DucDuyCPD/ascon_accerlerator/document/ascon_block_diagram.pdf

# thiết kế khối Ascon-Encrypt_Decrypt

## Mux

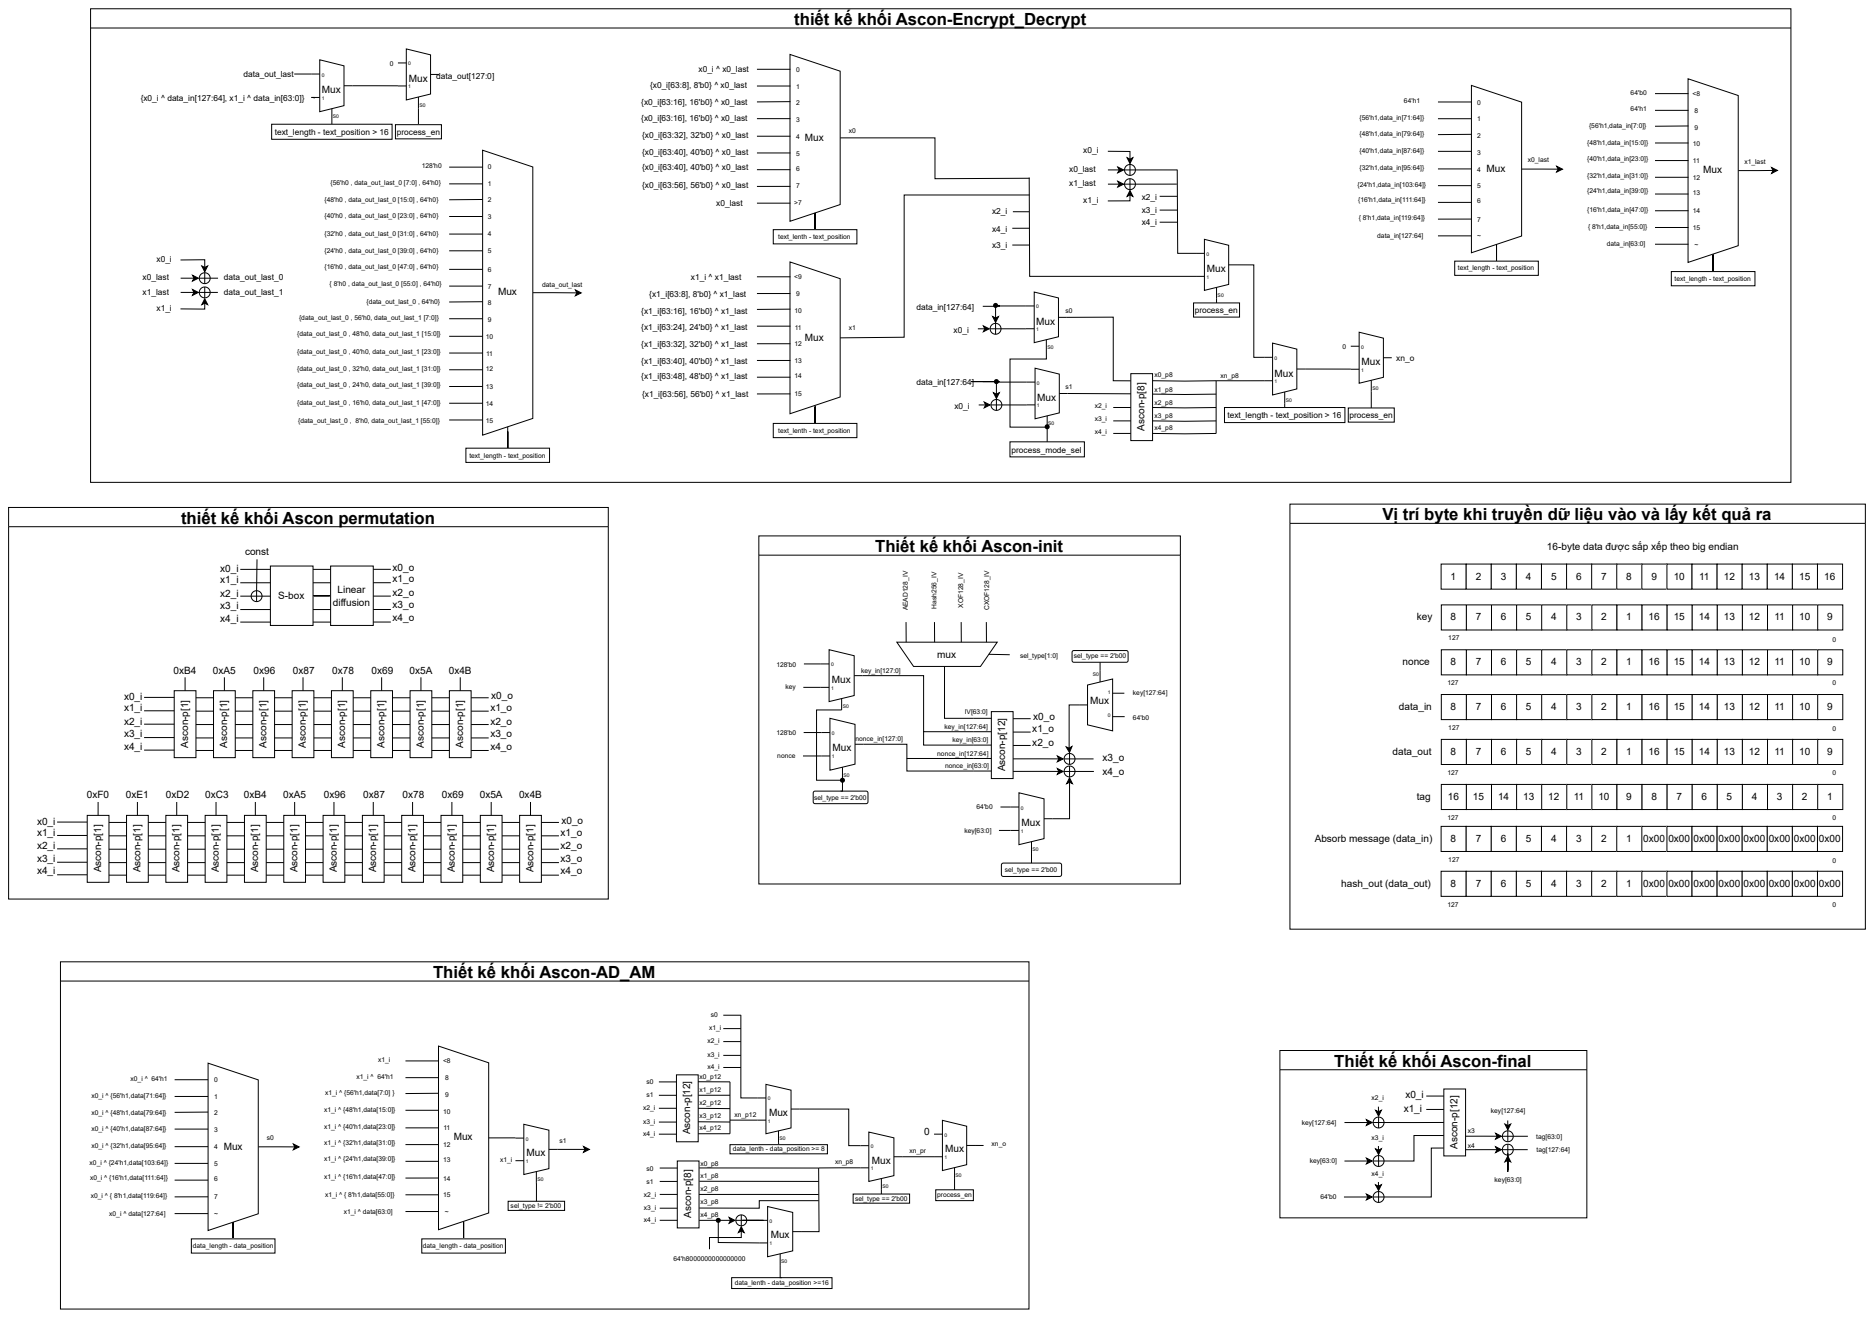
[picture p32: page 1]
text_length - text_position; {56'h1,data_in[71:64]}; {48'h1,data_in[79:64]}; {40'h1,data_in[87:64]}; {32'h1,data_in[95:64]}; {24'h1,data_in[103:64]}; {16'h1,data_in[111:64]}; { 8'h1,data_in[119:64]}; data_in[127:64]; x0_last; Mux; {56'h1,data_in[7:0]}; {48'h1,data_in[15:0]}; {40'h1,data_in[23:0]}; {32'h1,data_in[31:0]}; {24'h1,data_in[39:0]}; {16'h1,data_in[47:0]}; { 8'h1,data_in[55:0]}; data_in[63:0]; x1_last; process_en; data_out[127:0]; text_length - text_position > 16; process_mode_sel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

thiết kế khối Ascon permutation

Vị trí byte khi truyền dữ liệu vào và lấy kết quả ra

Thiết kế khối Ascon-init

16-byte data được sắp xếp theo big endian

Thiết kế khối Ascon-AD_AM

Thiết kế khối Ascon-final Ascon⁻p[12]

# Thiết kế khối Ascon Core (top module)

## mode_sel_encrypt_decrypt

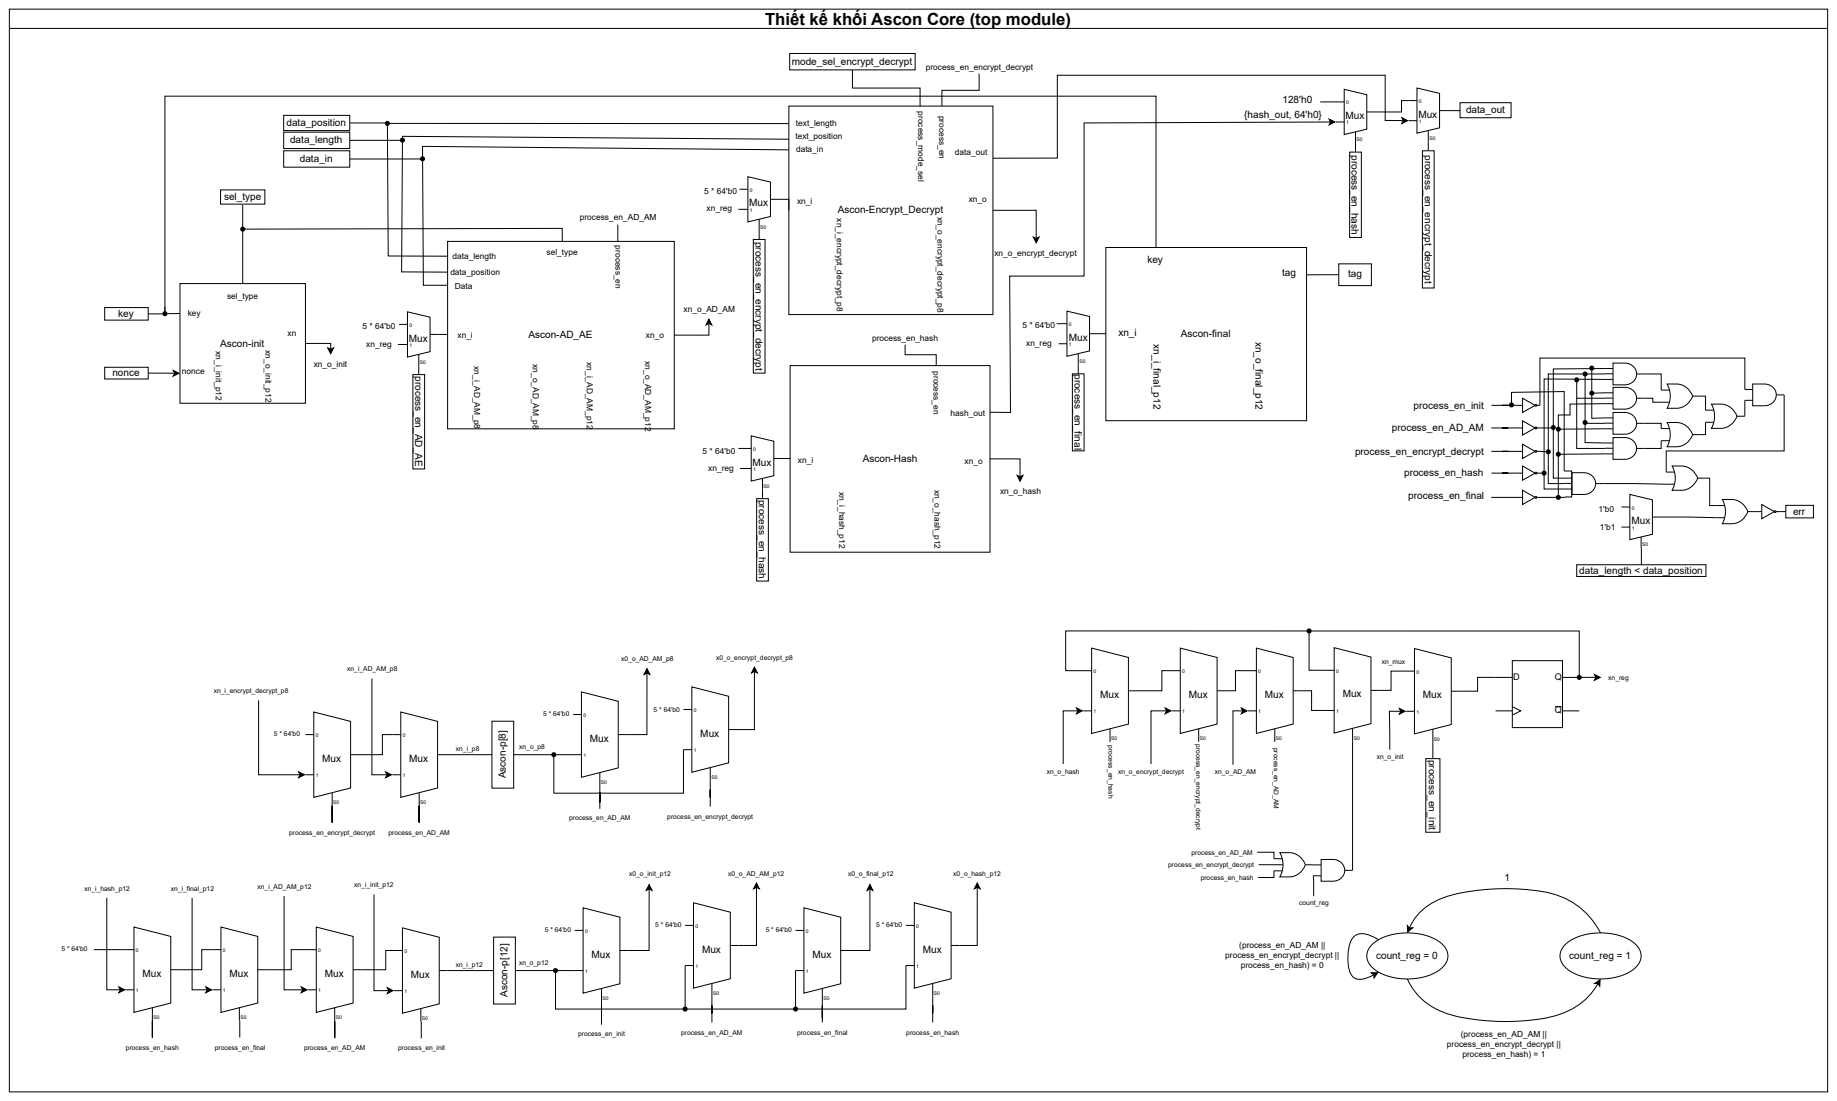
[picture p33: page 2]
Ascon-init; Ascon-AD_AE; Ascon-Encrypt_Decrypt; Ascon-Hash; Ascon-final; xn_i_init_p12; xn_o_init_p12; sel_type; key; nonce; xn_o process_en; sel_type data_length; data_position Data; xn_i_encrypt_decrypt_p8; xn_o_encrypt_decrypt_p8; data_out data_in; text_length text_position; process_mode_sel; process_en; hash_out; xn_o xn_i_hash_p12; xn_o_hash_p12; tag; xn_i_final_p12; xn_o_final_p12; Ascon-p[8]; Mux; process_en_encrypt_decrypt; process_en_AD_AM; x0_o_encrypt_decrypt_p8; Ascon-p[12]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
