DucDuyCPD/ascon_accerlerator/ascon_core_verilog/rtl/ascon_core.v

`timescale  1ns/1ps
module ascon_core (
	input wire clk,
	input wire rst_n,
	
	input wire [127:0] key,
	input wire [127:0] nonce,

	input wire [1:0] sel_type,
	input wire mode_sel_encrypt_decrypt,

	input wire [31:0] data_length,
	input wire [31:0] data_position,

	input wire [127:0] data_in,
	output reg [127:0] data_out,

	input wire process_en_init,
	input wire process_en_AD_AM,
	input wire process_en_encrypt_decrypt,
	input wire process_en_hash,
	input wire process_en_final,

	output reg [127:0] tag,
	output reg done,

	output wire err
);

parameter AEAD128 = 2'b00;
parameter Hash256 = 2'b01;
parameter XOF128  = 2'b10;
parameter CXOF128 = 2'b11;

reg [63:0] x0, x1, x2, x3, x4;
reg count;

wire err_length, err_process_en;
assign err_length = (data_length < data_position) ? 1'b1 : 1'b0;
assign err_process_en = (process_en_init | process_en_AD_AM | process_en_encrypt_decrypt | process_en_hash) & (process_en_init | process_en_AD_AM | process_en_encrypt_decrypt | process_en_final) & (process_en_init | process_en_AD_AM | process_en_hash | process_en_final) & (process_en_init | process_en_encrypt_decrypt | process_en_hash | process_en_final) & (process_en_AD_AM | process_en_encrypt_decrypt | process_en_hash | process_en_final);
assign err = err_length | err_process_en;

wire [63:0] x0_init, x1_init, x2_init, x3_init, x4_init;
wire [63:0] x0_i_AD_AM, x1_i_AD_AM, x2_i_AD_AM, x3_i_AD_AM, x4_i_AD_AM, x0_o_AD_AM, x1_o_AD_AM, x2_o_AD_AM, x3_o_AD_AM, x4_o_AD_AM;
wire [63:0] x0_i_encrypt_decrypt, x1_i_encrypt_decrypt, x2_i_encrypt_decrypt, x3_i_encrypt_decrypt, x4_i_encrypt_decrypt, x0_o_encrypt_decrypt, x1_o_encrypt_decrypt, x2_o_encrypt_decrypt, x3_o_encrypt_decrypt, x4_o_encrypt_decrypt;
wire [63:0] x0_i_final, x1_i_final, x2_i_final, x3_i_final, x4_i_final;
wire [63:0] x0_i_hash, x1_i_hash, x2_i_hash, x3_i_hash, x4_i_hash, x0_o_hash, x1_o_hash, x2_o_hash, x3_o_hash, x4_o_hash;

wire [127:0] encrypt_decrypt_out;
wire [63:0] hash_out;

wire [63:0] x0_i_p12, x1_i_p12, x2_i_p12, x3_i_p12, x4_i_p12, x0_i_p8, x1_i_p8, x2_i_p8, x3_i_p8, x4_i_p8;
wire [63:0] x0_o_p12, x1_o_p12, x2_o_p12, x3_o_p12, x4_o_p12, x0_o_p8, x1_o_p8, x2_o_p8, x3_o_p8, x4_o_p8;

wire [63:0] x0_i_init_p12, x1_i_init_p12, x2_i_init_p12, x3_i_init_p12, x4_i_init_p12;
wire [63:0] x0_o_init_p12, x1_o_init_p12, x2_o_init_p12, x3_o_init_p12, x4_o_init_p12;

wire [63:0] x0_i_AD_AM_p8, x1_i_AD_AM_p8, x2_i_AD_AM_p8, x3_i_AD_AM_p8, x4_i_AD_AM_p8;
wire [63:0] x0_o_AD_AM_p8, x1_o_AD_AM_p8, x2_o_AD_AM_p8, x3_o_AD_AM_p8, x4_o_AD_AM_p8;
wire [63:0] x0_i_AD_AM_p12, x1_i_AD_AM_p12, x2_i_AD_AM_p12, x3_i_AD_AM_p12, x4_i_AD_AM_p12;
wire [63:0] x0_o_AD_AM_p12, x1_o_AD_AM_p12, x2_o_AD_AM_p12, x3_o_AD_AM_p12, x4_o_AD_AM_p12;

wire [63:0] x0_i_encrypt_decrypt_p8, x1_i_encrypt_decrypt_p8, x2_i_encrypt_decrypt_p8, x3_i_encrypt_decrypt_p8, x4_i_encrypt_decrypt_p8;
wire [63:0] x0_o_encrypt_decrypt_p8, x1_o_encrypt_decrypt_p8, x2_o_encrypt_decrypt_p8, x3_o_encrypt_decrypt_p8, x4_o_encrypt_decrypt_p8;

wire [63:0] x0_i_hash_p12, x1_i_hash_p12, x2_i_hash_p12, x3_i_hash_p12, x4_i_hash_p12;
wire [63:0] x0_o_hash_p12, x1_o_hash_p12, x2_o_hash_p12, x3_o_hash_p12, x4_o_hash_p12;

wire [63:0] x0_i_final_p12, x1_i_final_p12, x2_i_final_p12, x3_i_final_p12, x4_i_final_p12;
wire [63:0] x3_o_final_p12, x4_o_final_p12;

wire [127:0] data_out_temp;
wire [127:0] tag_temp;

wire [63:0] x0_i_p, x1_i_p, x2_i_p, x3_i_p, x4_i_p;
wire [63:0] x0_o_p, x1_o_p, x2_o_p, x3_o_p, x4_o_p;
wire done_p, en_p8, en_p12;

assign data_out_temp = 	(process_en_encrypt_decrypt) ? encrypt_decrypt_out :
						(process_en_hash) ? {hash_out,64'b0} : data_out;

wire [63:0] x0_mux, x1_mux, x2_mux, x3_mux, x4_mux;

wire [63:0] x0_mux_temp, x1_mux_temp, x2_mux_temp, x3_mux_temp, x4_mux_temp;

assign x0_mux_temp = (process_en_AD_AM) ? x0_o_AD_AM : 
					(process_en_encrypt_decrypt) ? x0_o_encrypt_decrypt : 
					(process_en_hash) ? x0_o_hash : x0;
assign x0_mux = 	((process_en_AD_AM | process_en_encrypt_decrypt | process_en_hash) & count) ? x0_mux_temp : x0;
 
assign x1_mux_temp = (process_en_AD_AM) ? x1_o_AD_AM : 
					(process_en_encrypt_decrypt) ? x1_o_encrypt_decrypt : 
					(process_en_hash) ? x1_o_hash : x1;
assign x1_mux = 	((process_en_AD_AM | process_en_encrypt_decrypt | process_en_hash) & count) ? x1_mux_temp : x1;

assign x2_mux_temp = (process_en_AD_AM) ? x2_o_AD_AM : 
					(process_en_encrypt_decrypt) ? x2_o_encrypt_decrypt : 
					(process_en_hash) ? x2_o_hash : x2;
assign x2_mux = 	((process_en_AD_AM | process_en_encrypt_decrypt | process_en_hash) & count) ? x2_mux_temp : x2;

assign x3_mux_temp = (process_en_AD_AM) ? x3_o_AD_AM : 
					(process_en_encrypt_decrypt) ? x3_o_encrypt_decrypt : 
					(process_en_hash) ? x3_o_hash : x3;
assign x3_mux = 	((process_en_AD_AM | process_en_encrypt_decrypt | process_en_hash) & count) ? x3_mux_temp : x3;

assign x4_mux_temp = (process_en_AD_AM) ? x4_o_AD_AM : 
					(process_en_encrypt_decrypt) ? x4_o_encrypt_decrypt : 
					(process_en_hash) ? x4_o_hash : x4;
assign x4_mux = 	((process_en_AD_AM | process_en_encrypt_decrypt | process_en_hash) & count) ? x4_mux_temp : x4;

always @(posedge clk or negedge rst_n) begin
	if(~rst_n) begin
		x0 <= 64'b0;
		x1 <= 64'b0;
		x2 <= 64'b0;
		x3 <= 64'b0;
		x4 <= 64'b0;
		count <= 0;
		data_out <= 128'b0;
		done <=  0;
		tag <= 128'h0;
	end else begin
		if (err) begin
			x0 <= 64'b0;
			x1 <= 64'b0;
			x2 <= 64'b0;
			x3 <= 64'b0;
			x4 <= 64'b0;
			count <= 0;
			data_out <= 128'b0;
			done <=  0;
			tag <= 128'h0;
		end else begin
			data_out <= data_out_temp;
			if (process_en_init & done_p) begin
				x0 <= x0_init;
				x1 <= x1_init;
				x2 <= x2_init;
				x3 <= x3_init;
				x4 <= x4_init;
				done <= 1'b1;
			end else begin
				done <=  count;
				if (count == 1'b0) begin
					if ((process_en_AD_AM | process_en_encrypt_decrypt | process_en_hash | process_en_final) & done_p) count <= 1'b1; 
					else count <= 1'b0;
				end else begin
					x0 <= x0_mux;
					x1 <= x1_mux;
					x2 <= x2_mux;
					x3 <= x3_mux;
					x4 <= x4_mux;
					tag <= tag_temp;
					count <= 1'b0;
				end
			end
		end
	end
end

assign x0_i_p8 = 	(process_en_AD_AM) ? x0_i_AD_AM_p8 : 
					(process_en_encrypt_decrypt) ? x0_i_encrypt_decrypt_p8 : 64'b0;
assign x1_i_p8 = 	(process_en_AD_AM) ? x1_i_AD_AM_p8 : 
					(process_en_encrypt_decrypt) ? x1_i_encrypt_decrypt_p8 : 64'b0;
assign x2_i_p8 = 	(process_en_AD_AM) ? x2_i_AD_AM_p8 : 
					(process_en_encrypt_decrypt) ? x2_i_encrypt_decrypt_p8 : 64'b0;
assign x3_i_p8 = 	(process_en_AD_AM) ? x3_i_AD_AM_p8 : 
					(process_en_encrypt_decrypt) ? x3_i_encrypt_decrypt_p8 : 64'b0;
assign x4_i_p8 = 	(process_en_AD_AM) ? x4_i_AD_AM_p8 : 
					(process_en_encrypt_decrypt) ? x4_i_encrypt_decrypt_p8 : 64'b0;

assign x0_i_p12 =	(process_en_init) ? x0_i_init_p12 :
					(process_en_AD_AM) ? x0_i_AD_AM_p12 :
					(process_en_final) ? x0_i_final_p12 :
					(process_en_hash) ? x0_i_hash_p12 : 64'b0;
assign x1_i_p12 =	(process_en_init) ? x1_i_init_p12 :
					(process_en_AD_AM) ? x1_i_AD_AM_p12 :
					(process_en_final) ? x1_i_final_p12 :
					(process_en_hash) ? x1_i_hash_p12 : 64'b0;
assign x2_i_p12 =	(process_en_init) ? x2_i_init_p12 :
					(process_en_AD_AM) ? x2_i_AD_AM_p12 :
					(process_en_final) ? x2_i_final_p12 :
					(process_en_hash) ? x2_i_hash_p12 : 64'b0; 
assign x3_i_p12 =	(process_en_init) ? x3_i_init_p12 :
					(process_en_AD_AM) ? x3_i_AD_AM_p12 :
					(process_en_final) ? x3_i_final_p12 :
					(process_en_hash) ? x3_i_hash_p12 : 64'b0;
assign x4_i_p12 =	(process_en_init) ? x4_i_init_p12 :
					(process_en_AD_AM) ? x4_i_AD_AM_p12 :
					(process_en_final) ? x4_i_final_p12 :
					(process_en_hash) ? x4_i_hash_p12 : 64'b0;

assign x0_o_init_p12 = (process_en_init) ? x0_o_p12 : 64'b0;
assign x1_o_init_p12 = (process_en_init) ? x1_o_p12 : 64'b0;
assign x2_o_init_p12 = (process_en_init) ? x2_o_p12 : 64'b0;
assign x3_o_init_p12 = (process_en_init) ? x3_o_p12 : 64'b0;
assign x4_o_init_p12 = (process_en_init) ? x4_o_p12 : 64'b0;

assign x0_o_AD_AM_p8 = (process_en_AD_AM) ? x0_o_p8 : 64'b0;
assign x1_o_AD_AM_p8 = (process_en_AD_AM) ? x1_o_p8 : 64'b0;
assign x2_o_AD_AM_p8 = (process_en_AD_AM) ? x2_o_p8 : 64'b0;
assign x3_o_AD_AM_p8 = (process_en_AD_AM) ? x3_o_p8 : 64'b0;
assign x4_o_AD_AM_p8 = (process_en_AD_AM) ? x4_o_p8 : 64'b0;

assign x0_o_AD_AM_p12 = (process_en_AD_AM) ? x0_o_p12 : 64'b0;
assign x1_o_AD_AM_p12 = (process_en_AD_AM) ? x1_o_p12 : 64'b0;
assign x2_o_AD_AM_p12 = (process_en_AD_AM) ? x2_o_p12 : 64'b0;
assign x3_o_AD_AM_p12 = (process_en_AD_AM) ? x3_o_p12 : 64'b0;
assign x4_o_AD_AM_p12 = (process_en_AD_AM) ? x4_o_p12 : 64'b0;

assign x0_o_encrypt_decrypt_p8 = (process_en_encrypt_decrypt) ? x0_o_p8 : 64'b0;
assign x1_o_encrypt_decrypt_p8 = (process_en_encrypt_decrypt) ? x1_o_p8 : 64'b0;
assign x2_o_encrypt_decrypt_p8 = (process_en_encrypt_decrypt) ? x2_o_p8 : 64'b0;
assign x3_o_encrypt_decrypt_p8 = (process_en_encrypt_decrypt) ? x3_o_p8 : 64'b0;
assign x4_o_encrypt_decrypt_p8 = (process_en_encrypt_decrypt) ? x4_o_p8 : 64'b0;

assign x0_o_hash_p12 = (process_en_hash) ? x0_o_p12 : 64'b0;
assign x1_o_hash_p12 = (process_en_hash) ? x1_o_p12 : 64'b0;
assign x2_o_hash_p12 = (process_en_hash) ? x2_o_p12 : 64'b0;
assign x3_o_hash_p12 = (process_en_hash) ? x3_o_p12 : 64'b0;
assign x4_o_hash_p12 = (process_en_hash) ? x4_o_p12 : 64'b0;

assign x3_o_final_p12 = (process_en_final) ? x3_o_p12 : 64'b0;
assign x4_o_final_p12 = (process_en_final) ? x4_o_p12 : 64'b0;

ascon_initialization ascon_initialization_module(
	.sel_type(sel_type),
	.key(key),
	.nonce(nonce),

	.x0(x0_init),
	.x1(x1_init),
	.x2(x2_init),
	.x3(x3_init),
	.x4(x4_init),

	.x0_i_init_p12(x0_i_init_p12),
	.x1_i_init_p12(x1_i_init_p12),
	.x2_i_init_p12(x2_i_init_p12),
	.x3_i_init_p12(x3_i_init_p12),
	.x4_i_init_p12(x4_i_init_p12),

	.x0_o_init_p12(x0_o_init_p12),
	.x1_o_init_p12(x1_o_init_p12),
	.x2_o_init_p12(x2_o_init_p12),
	.x3_o_init_p12(x3_o_init_p12),
	.x4_o_init_p12(x4_o_init_p12)
);

assign x0_i_AD_AM = (process_en_AD_AM) ? x0 : 64'b0;
assign x1_i_AD_AM = (process_en_AD_AM) ? x1 : 64'b0;
assign x2_i_AD_AM = (process_en_AD_AM) ? x2 : 64'b0;
assign x3_i_AD_AM = (process_en_AD_AM) ? x3 : 64'b0;
assign x4_i_AD_AM = (process_en_AD_AM) ? x4 : 64'b0;

ascon_AD_AM ascon_AD_AM_module(
	.clk(clk), .rst_n(rst_n),

	.process_en(process_en_AD_AM),
	.sel_type(sel_type),

	.data_length(data_length),
	.data_position(data_position),

	.data(data_in),

	.x0_i(x0_i_AD_AM),
	.x1_i(x1_i_AD_AM),
	.x2_i(x2_i_AD_AM),
	.x3_i(x3_i_AD_AM),
	.x4_i(x4_i_AD_AM),

	.x0_o(x0_o_AD_AM),
	.x1_o(x1_o_AD_AM),
	.x2_o(x2_o_AD_AM),
	.x3_o(x3_o_AD_AM),
	.x4_o(x4_o_AD_AM),

	.x0_i_AD_AM_p8(x0_i_AD_AM_p8),
	.x1_i_AD_AM_p8(x1_i_AD_AM_p8),
	.x2_i_AD_AM_p8(x2_i_AD_AM_p8),
	.x3_i_AD_AM_p8(x3_i_AD_AM_p8),
	.x4_i_AD_AM_p8(x4_i_AD_AM_p8),

	.x0_o_AD_AM_p8(x0_o_AD_AM_p8),
	.x1_o_AD_AM_p8(x1_o_AD_AM_p8),
	.x2_o_AD_AM_p8(x2_o_AD_AM_p8),
	.x3_o_AD_AM_p8(x3_o_AD_AM_p8),
	.x4_o_AD_AM_p8(x4_o_AD_AM_p8),

	.x0_i_AD_AM_p12(x0_i_AD_AM_p12),
	.x1_i_AD_AM_p12(x1_i_AD_AM_p12),
	.x2_i_AD_AM_p12(x2_i_AD_AM_p12),
	.x3_i_AD_AM_p12(x3_i_AD_AM_p12),
	.x4_i_AD_AM_p12(x4_i_AD_AM_p12),

	.x0_o_AD_AM_p12(x0_o_AD_AM_p12),
	.x1_o_AD_AM_p12(x1_o_AD_AM_p12),
	.x2_o_AD_AM_p12(x2_o_AD_AM_p12),
	.x3_o_AD_AM_p12(x3_o_AD_AM_p12),
	.x4_o_AD_AM_p12(x4_o_AD_AM_p12)
);

assign x0_i_encrypt_decrypt = (process_en_encrypt_decrypt) ? x0 : 64'b0;
assign x1_i_encrypt_decrypt = (process_en_encrypt_decrypt) ? x1 : 64'b0;
assign x2_i_encrypt_decrypt = (process_en_encrypt_decrypt) ? x2 : 64'b0;
assign x3_i_encrypt_decrypt = (process_en_encrypt_decrypt) ? x3 : 64'b0;
assign x4_i_encrypt_decrypt = (process_en_encrypt_decrypt) ? x4 : 64'b0;

ascon_encrypt_decrypt ascon_encrypt_decrypt_module(
	.clk(clk), .rst_n(rst_n),

	.process_en(process_en_encrypt_decrypt),
	.process_mode_sel(mode_sel_encrypt_decrypt),

	.text_length(data_length),
	.text_position(data_position),

	.data_in(data_in),

	.x0_i(x0_i_encrypt_decrypt),
	.x1_i(x1_i_encrypt_decrypt),
	.x2_i(x2_i_encrypt_decrypt),
	.x3_i(x3_i_encrypt_decrypt),
	.x4_i(x4_i_encrypt_decrypt),

	.data_out(encrypt_decrypt_out),

	.x0_o(x0_o_encrypt_decrypt),
	.x1_o(x1_o_encrypt_decrypt),
	.x2_o(x2_o_encrypt_decrypt),
	.x3_o(x3_o_encrypt_decrypt),
	.x4_o(x4_o_encrypt_decrypt),

	.x0_i_encrypt_decrypt_p8(x0_i_encrypt_decrypt_p8),
	.x1_i_encrypt_decrypt_p8(x1_i_encrypt_decrypt_p8),
	.x2_i_encrypt_decrypt_p8(x2_i_encrypt_decrypt_p8),
	.x3_i_encrypt_decrypt_p8(x3_i_encrypt_decrypt_p8),
	.x4_i_encrypt_decrypt_p8(x4_i_encrypt_decrypt_p8),

	.x0_o_encrypt_decrypt_p8(x0_o_encrypt_decrypt_p8),
	.x1_o_encrypt_decrypt_p8(x1_o_encrypt_decrypt_p8),
	.x2_o_encrypt_decrypt_p8(x2_o_encrypt_decrypt_p8),
	.x3_o_encrypt_decrypt_p8(x3_o_encrypt_decrypt_p8),
	.x4_o_encrypt_decrypt_p8(x4_o_encrypt_decrypt_p8)
);

assign x0_i_final = (process_en_final) ? x0 : 64'b0;
assign x1_i_final = (process_en_final) ? x1 : 64'b0;
assign x2_i_final = (process_en_final) ? x2 : 64'b0;
assign x3_i_final = (process_en_final) ? x3 : 64'b0;
assign x4_i_final = (process_en_final) ? x4 : 64'b0;

ascon_finalization ascon_finalization_module(
	.clk(clk), .rst_n(rst_n),

	.process_en(process_en_final),

	.key(key),

	.x0_i(x0_i_final),
	.x1_i(x1_i_final),
	.x2_i(x2_i_final),
	.x3_i(x3_i_final),
	.x4_i(x4_i_final),

	.tag(tag_temp),

	.x0_i_final_p12(x0_i_final_p12),
	.x1_i_final_p12(x1_i_final_p12),
	.x2_i_final_p12(x2_i_final_p12),
	.x3_i_final_p12(x3_i_final_p12),
	.x4_i_final_p12(x4_i_final_p12),

	.x3_o_final_p12(x3_o_final_p12),
	.x4_o_final_p12(x4_o_final_p12)
);

assign x0_i_hash = (process_en_hash) ? x0 : 64'b0;
assign x1_i_hash = (process_en_hash) ? x1 : 64'b0;
assign x2_i_hash = (process_en_hash) ? x2 : 64'b0;
assign x3_i_hash = (process_en_hash) ? x3 : 64'b0;
assign x4_i_hash = (process_en_hash) ? x4 : 64'b0;

ascon_hash ascon_hash_module(
	.clk(clk),
	.rst_n(rst_n),

	.process_en(process_en_hash),
	
	.x0_i(x0_i_hash),
	.x1_i(x1_i_hash),
	.x2_i(x2_i_hash),
	.x3_i(x3_i_hash),
	.x4_i(x4_i_hash),

	.x0_o(x0_o_hash),
	.x1_o(x1_o_hash),
	.x2_o(x2_o_hash),
	.x3_o(x3_o_hash),
	.x4_o(x4_o_hash),

	.hash_out(hash_out),

	.x0_i_hash_p12(x0_i_hash_p12),
	.x1_i_hash_p12(x1_i_hash_p12),
	.x2_i_hash_p12(x2_i_hash_p12),
	.x3_i_hash_p12(x3_i_hash_p12),
	.x4_i_hash_p12(x4_i_hash_p12),

	.x0_o_hash_p12(x0_o_hash_p12),
	.x1_o_hash_p12(x1_o_hash_p12),
	.x2_o_hash_p12(x2_o_hash_p12),
	.x3_o_hash_p12(x3_o_hash_p12),
	.x4_o_hash_p12(x4_o_hash_p12)
);

assign en_p8 = (((process_en_AD_AM & (sel_type == AEAD128)) | process_en_encrypt_decrypt) & ~done) ? 1'b1 : 1'b0;
assign en_p12 = ((process_en_init | process_en_hash | process_en_final | (process_en_AD_AM & (sel_type != AEAD128))) & ~done) ? 1'b1 : 1'b0;

assign x0_i_p = (en_p8) ? x0_i_p8 :	(en_p12) ? x0_i_p12 : 64'b0;
assign x1_i_p = (en_p8) ? x1_i_p8 :	(en_p12) ? x1_i_p12 : 64'b0;
assign x2_i_p = (en_p8) ? x2_i_p8 :	(en_p12) ? x2_i_p12 : 64'b0;
assign x3_i_p = (en_p8) ? x3_i_p8 :	(en_p12) ? x3_i_p12 : 64'b0;
assign x4_i_p = (en_p8) ? x4_i_p8 :	(en_p12) ? x4_i_p12 : 64'b0;

assign x0_o_p8 = (en_p8) ? x0_o_p : 64'b0;
assign x1_o_p8 = (en_p8) ? x1_o_p : 64'b0;
assign x2_o_p8 = (en_p8) ? x2_o_p : 64'b0;
assign x3_o_p8 = (en_p8) ? x3_o_p : 64'b0;
assign x4_o_p8 = (en_p8) ? x4_o_p : 64'b0;

assign x0_o_p12 = (en_p12) ? x0_o_p : 64'b0;
assign x1_o_p12 = (en_p12) ? x1_o_p : 64'b0;
assign x2_o_p12 = (en_p12) ? x2_o_p : 64'b0;
assign x3_o_p12 = (en_p12) ? x3_o_p : 64'b0;
assign x4_o_p12 = (en_p12) ? x4_o_p : 64'b0;

ascon_permutation_multicycle_p4 ascon_permutation_multicycle_p4_module(
	.clk(clk),    // Clock
	.rst_n(rst_n),  // Asynchronous reset active low

	.en_p8(en_p8),
	.en_p12(en_p12),
	
	.x0_i(x0_i_p),
	.x1_i(x1_i_p),
	.x2_i(x2_i_p),
	.x3_i(x3_i_p),
	.x4_i(x4_i_p),

	.x0_o(x0_o_p),
	.x1_o(x1_o_p),
	.x2_o(x2_o_p),
	.x3_o(x3_o_p),
	.x4_o(x4_o_p),

	.done(done_p)
);

// ascon_permutation_p12 ascon_p12(
// 	.x0_i(x0_i_p12),
// 	.x1_i(x1_i_p12),
// 	.x2_i(x2_i_p12),
// 	.x3_i(x3_i_p12),
// 	.x4_i(x4_i_p12),

// 	.x0_o(x0_o_p12),
// 	.x1_o(x1_o_p12),
// 	.x2_o(x2_o_p12),
// 	.x3_o(x3_o_p12),
// 	.x4_o(x4_o_p12)
// );

// ascon_permutation_p8 ascon_p8(
// 	.x0_i(x0_i_p8),
// 	.x1_i(x1_i_p8),
// 	.x2_i(x2_i_p8),
// 	.x3_i(x3_i_p8),
// 	.x4_i(x4_i_p8),

// 	.x0_o(x0_o_p8),
// 	.x1_o(x1_o_p8),
// 	.x2_o(x2_o_p8),
// 	.x3_o(x3_o_p8),
// 	.x4_o(x4_o_p8)
// );

endmodule
