DucDuyCPD/ascon_accerlerator/ascon_core_verilog/rtl/ascon_AD_AM.v

`timescale  1ns/1ps
module ascon_AD_AM ( //ascon's associated data and absorb message
	input wire clk, rst_n,

	input wire process_en,

	input wire [1:0] sel_type,

	input wire [31:0] data_length,
	input wire [31:0] data_position,

	input wire [127:0] data,

	input wire [63:0] x0_i,
	input wire [63:0] x1_i,
	input wire [63:0] x2_i,
	input wire [63:0] x3_i,
	input wire [63:0] x4_i,

	output reg [63:0] x0_o,
	output reg [63:0] x1_o,
	output reg [63:0] x2_o,
	output reg [63:0] x3_o,
	output reg [63:0] x4_o,

	output wire [63:0] x0_i_AD_AM_p8,
	output wire [63:0] x1_i_AD_AM_p8,
	output wire [63:0] x2_i_AD_AM_p8,
	output wire [63:0] x3_i_AD_AM_p8,
	output wire [63:0] x4_i_AD_AM_p8,

	input  wire [63:0] x0_o_AD_AM_p8,
	input  wire [63:0] x1_o_AD_AM_p8,
	input  wire [63:0] x2_o_AD_AM_p8,
	input  wire [63:0] x3_o_AD_AM_p8,
	input  wire [63:0] x4_o_AD_AM_p8,

	output wire [63:0] x0_i_AD_AM_p12,
	output wire [63:0] x1_i_AD_AM_p12,
	output wire [63:0] x2_i_AD_AM_p12,
	output wire [63:0] x3_i_AD_AM_p12,
	output wire [63:0] x4_i_AD_AM_p12,

	input  wire [63:0] x0_o_AD_AM_p12,
	input  wire [63:0] x1_o_AD_AM_p12,
	input  wire [63:0] x2_o_AD_AM_p12,
	input  wire [63:0] x3_o_AD_AM_p12,
	input  wire [63:0] x4_o_AD_AM_p12
);
parameter AEAD128 = 2'b00;
parameter Hash256 = 2'b01;
parameter XOF128  = 2'b10;
parameter CXOF128 = 2'b11;

wire [63:0] x0_p8, x1_p8, x2_p8, x3_p8, x4_p8;
wire [63:0] x0_p12, x1_p12, x2_p12, x3_p12, x4_p12;

wire [63:0] s0, s1, s2, s3, s4; 
wire [63:0] x0_o_temp_AD, x1_o_temp_AD, x2_o_temp_AD, x3_o_temp_AD, x4_o_temp_AD;
wire [63:0] x0_o_temp_AM, x1_o_temp_AM, x2_o_temp_AM, x3_o_temp_AM, x4_o_temp_AM;
wire [63:0] x0_o_temp, x1_o_temp, x2_o_temp, x3_o_temp, x4_o_temp;

wire [31:0] length_minus_position;

assign length_minus_position = data_length - data_position;

always @(posedge clk or negedge rst_n)begin
	if (~rst_n) begin
		x0_o <= 64'b0;
		x1_o <= 64'b0;
		x2_o <= 64'b0;
		x3_o <= 64'b0;
		x4_o <= 64'b0;
	end
	else begin
		if (process_en) begin
			x0_o <= x0_o_temp;
			x1_o <= x1_o_temp;
			x2_o <= x2_o_temp;
			x3_o <= x3_o_temp;
			x4_o <= x4_o_temp;
		end
	end
end

assign x0_o_temp_AD = 	(data_length == 0) ? x0_i : x0_p8;
assign x1_o_temp_AD = 	(data_length == 0) ? x1_i : x1_p8;
assign x2_o_temp_AD = 	(data_length == 0) ? x2_i : x2_p8;
assign x3_o_temp_AD = 	(data_length == 0) ? x3_i : x3_p8;
assign x4_o_temp_AD = 	(length_minus_position >= 16) ? x4_p8 : 
						(data_length == 0) ? x4_i ^ 64'h80_00_00_00_00_00_00_00 : x4_p8 ^ 64'h80_00_00_00_00_00_00_00;

assign x0_o_temp_AM = 	(length_minus_position >= 8) ? x0_p12 : s0;
assign x1_o_temp_AM = 	(length_minus_position >= 8) ? x1_p12 : x1_i;
assign x2_o_temp_AM = 	(length_minus_position >= 8) ? x2_p12 : x2_i;
assign x3_o_temp_AM = 	(length_minus_position >= 8) ? x3_p12 : x3_i;
assign x4_o_temp_AM = 	(length_minus_position >= 8) ? x4_p12 : x4_i;

assign x0_o_temp = (sel_type == AEAD128) ? x0_o_temp_AD : x0_o_temp_AM;
assign x1_o_temp = (sel_type == AEAD128) ? x1_o_temp_AD : x1_o_temp_AM;
assign x2_o_temp = (sel_type == AEAD128) ? x2_o_temp_AD : x2_o_temp_AM;
assign x3_o_temp = (sel_type == AEAD128) ? x3_o_temp_AD : x3_o_temp_AM;
assign x4_o_temp = (sel_type == AEAD128) ? x4_o_temp_AD : x4_o_temp_AM;

assign s0 =		(length_minus_position == 0 ) ? x0_i ^  64'h1 :
			(length_minus_position == 1 ) ? x0_i ^ {56'h1,data[71:64]} :
			(length_minus_position == 2 ) ? x0_i ^ {48'h1,data[79:64]} :
			(length_minus_position == 3 ) ? x0_i ^ {40'h1,data[87:64]} :
			(length_minus_position == 4 ) ? x0_i ^ {32'h1,data[95:64]} :
			(length_minus_position == 5 ) ? x0_i ^ {24'h1,data[103:64]} :
			(length_minus_position == 6 ) ? x0_i ^ {16'h1,data[111:64]} :
			(length_minus_position == 7 ) ? x0_i ^ { 8'h1,data[119:64]} : x0_i ^ data[127:64];

assign s1 = (sel_type != AEAD128) ? x1_i : 
			(length_minus_position == 0 ) ? x1_i :
			(length_minus_position == 1 ) ? x1_i :
			(length_minus_position == 2 ) ? x1_i :
			(length_minus_position == 3 ) ? x1_i :
			(length_minus_position == 4 ) ? x1_i :
			(length_minus_position == 5 ) ? x1_i :
			(length_minus_position == 6 ) ? x1_i :
			(length_minus_position == 7 ) ? x1_i :
			(length_minus_position == 8 ) ? x1_i ^  64'h1:
			(length_minus_position == 9 ) ? x1_i ^ {56'h1,data[7:0] } :
			(length_minus_position == 10) ? x1_i ^ {48'h1,data[15:0]} :
			(length_minus_position == 11) ? x1_i ^ {40'h1,data[23:0]} :
			(length_minus_position == 12) ? x1_i ^ {32'h1,data[31:0]} :
			(length_minus_position == 13) ? x1_i ^ {24'h1,data[39:0]} :
			(length_minus_position == 14) ? x1_i ^ {16'h1,data[47:0]} :
			(length_minus_position == 15) ? x1_i ^ { 8'h1,data[55:0]} : x1_i ^ data[63:0];

assign s2 = x2_i;
assign s3 = x3_i;
assign s4 = x4_i;

assign x0_i_AD_AM_p8 = s0;
assign x1_i_AD_AM_p8 = s1;
assign x2_i_AD_AM_p8 = s2;
assign x3_i_AD_AM_p8 = s3;
assign x4_i_AD_AM_p8 = s4;

assign x0_p8 = x0_o_AD_AM_p8;
assign x1_p8 = x1_o_AD_AM_p8;
assign x2_p8 = x2_o_AD_AM_p8;
assign x3_p8 = x3_o_AD_AM_p8;
assign x4_p8 = x4_o_AD_AM_p8;

assign x0_i_AD_AM_p12 = s0;
assign x1_i_AD_AM_p12 = s1;
assign x2_i_AD_AM_p12 = s2;
assign x3_i_AD_AM_p12 = s3;
assign x4_i_AD_AM_p12 = s4;

assign x0_p12 = x0_o_AD_AM_p12;
assign x1_p12 = x1_o_AD_AM_p12;
assign x2_p12 = x2_o_AD_AM_p12;
assign x3_p12 = x3_o_AD_AM_p12;
assign x4_p12 = x4_o_AD_AM_p12;

endmodule
